adafruit/Adafruit-LSM6DS33-LIS3MDL-PCB/Adafruit LIS3MDL + LSM6DS33.brd

## EAGLE design Adafruit LIS3MDL + LSM6DS33.brd (2020-06-10)

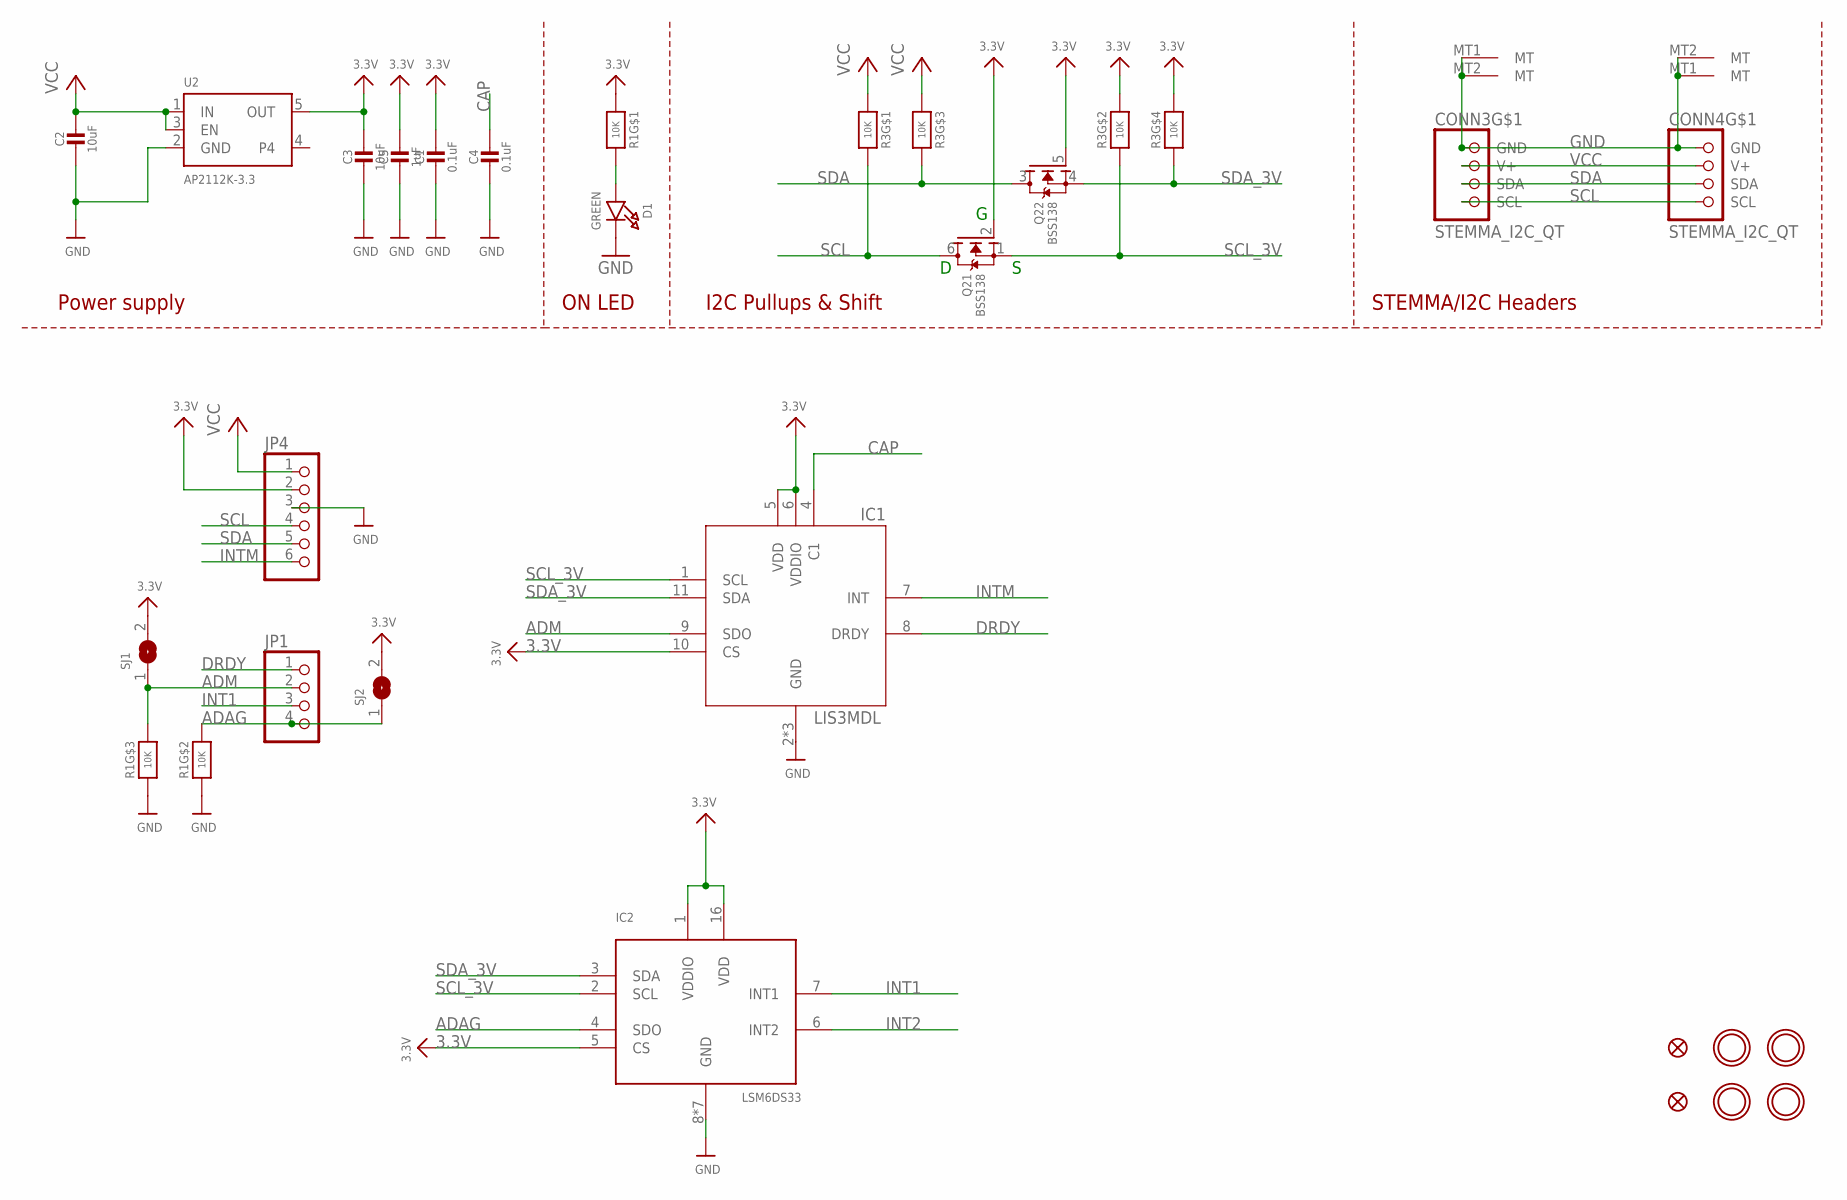
[picture p2: schematic Adafruit LIS3MDL + LSM6DS33.sch]

Parts:
C1, C4: 0.1uF; 0603-NO
C2, C3: 10uF; 0805-NO
C5: 1uF; 0603-NO
CONN3, CONN4: STEMMA_I2C_QT; JST_SH4
D1: GREEN; CHIPLED_0603_NOOUTLINE
FID3, FID4: FIDUCIAL_1MM
IC1: LIS3MDL; LGA12_2X2MM
IC2: LSM6DS33; LGA16_3X3MM
JP1: HEADER-1X4ROUND; 1X04_ROUND
JP4: HEADER-1X670MIL; 1X06_ROUND_70
Q2: BSS138; SOT363
R1, R3: 10K; RESPACK_4X0603
SJ1, SJ2: SOLDERJUMPER; SOLDERJUMPER_ARROW_NOPASTE
U2: AP2112K-3.3; SOT23-5
U$1, U$17, U$19, U$21: MOUNTINGHOLE2.5; MOUNTINGHOLE_2.5_PLATED

Connections:
3.3V: C1.1, C3.1, C5.1, IC1.5 (VDD), IC1.6 (VDDIO), IC1.10 (CS), IC2.1 (VDDIO), IC2.5 (CS), IC2.16 (VDD), JP4.2, Q2.2 (G), Q2.5 (G), R1.1, R3.2 (1), R3.4 (1), SJ1.2, SJ2.2, U2.5 (OUT)
ADAG: IC2.4 (SDO), JP1.4, R1.7 (2), SJ2.1
ADM: IC1.9 (SDO), JP1.2, R1.6 (2), SJ1.1
CAP: C4.1, IC1.4 (C1)
DRDY: IC1.8 (DRDY), JP1.1
GND: C1.2, C2.2, C3.2, C4.2, C5.2, CONN3.1 (GND), CONN3.MT1 (MT), CONN3.MT2 (MT), CONN4.1 (GND), CONN4.MT1 (MT), CONN4.MT2 (MT), D1.C, IC1.2 (GND), IC1.3 (GND), IC1.12 (GND), IC2.8 (GND), IC2.9 (GND), IC2.10 (GND), IC2.11 (GND), IC2.12 (GND), IC2.13 (GND), IC2.15 (GND), JP4.3, R1.2 (1), R1.3 (1), U2.2 (GND)
INT1: IC2.7 (INT1), JP1.3
INT2: IC2.6 (INT2)
INTM: IC1.7 (INT), JP4.6
unnamed: D1.A, R1.8 (2)
SCL: CONN3.4 (SCL), CONN4.4 (SCL), JP4.4, Q2.6 (D), R3.8 (2)
SCL_3V: IC1.1 (SCL), IC2.2 (SCL), Q2.1 (S), R3.7 (2)
SDA: CONN3.3 (SDA), CONN4.3 (SDA), JP4.5, Q2.3 (D), R3.6 (2)
SDA_3V: IC1.11 (SDA), IC2.3 (SDA), Q2.4 (S), R3.5 (2)
VCC: C2.1, CONN3.2 (V+), CONN4.2 (V+), JP4.1, R3.1, R3.3 (1), U2.1 (IN), U2.3 (EN)

Notes on the sheet:
I2C Pullups & Shift
STEMMA/I2C Headers
ON LED
Power supply

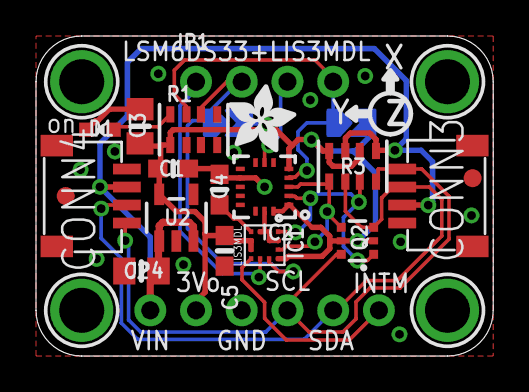
[picture p3: board Adafruit LIS3MDL + LSM6DS33.brd from above]

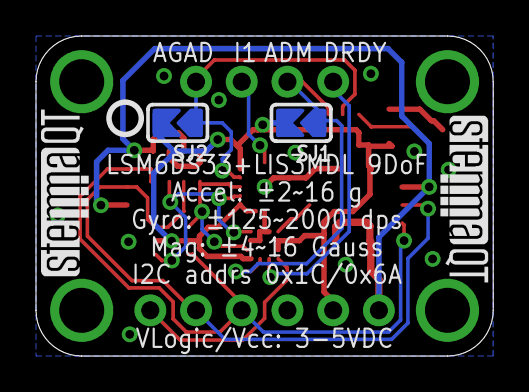
[picture p4: board Adafruit LIS3MDL + LSM6DS33.brd from below]

Board: 2 copper layers, 25.4 x 17.8 mm, 28 parts (5 on the bottom side), 14 nets.

Other parts of the board:
U$20: ADAFRUIT_3.5MM
U$25: PCBFEAT-REV-040
U$30, U$31: STEMMAQT
